ianm8/SW30/README.md

# SW30
A shortwave communications receiver with classic visual design. The SW30 is an SDR that uses quadrature sampling detection.



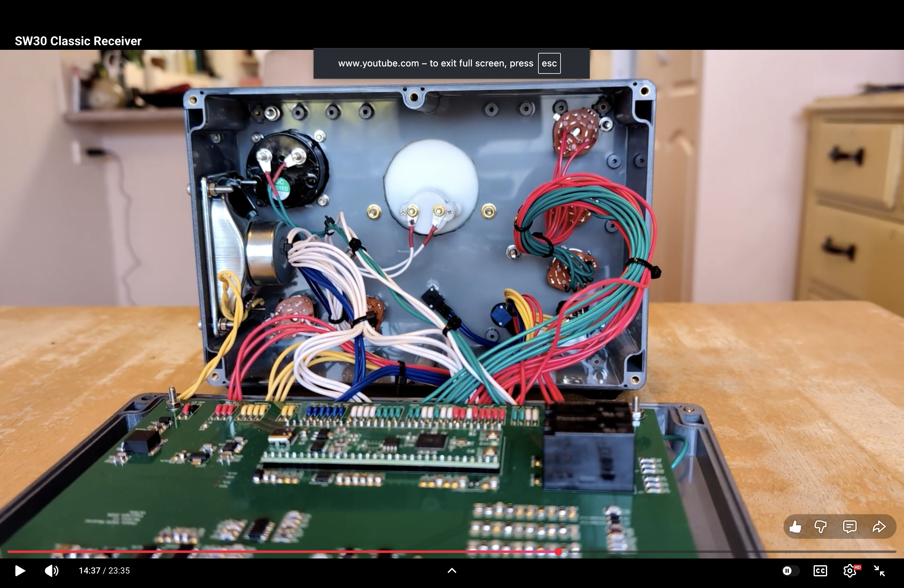
[picture p2: docs/SW30-Video.png]
IMAGE ALT TEXT HERE (https://www.youtube.com/watch?v=dTe6R9eRhOo)


73 VK7IAN
