ianm8/SW30/docs/README.md

## Revision 1.1
 * U14 MC74VHC1GT125DBVT1G
 * U3 BGA616H6327XTSA1
 * Change R49 to 3k
 * Change R55 to 2W

## BOM Notes
* The 5V FSD meter was chosen so that if you don't want to change the dial face then 1 volt represents 1 MHz
* The TCXO can be 25, 26 or 27 MHz (just need to update the source code)
