ianm8/SW30/docs/Schematic_Classic-SW30_2026-02-25.pdf

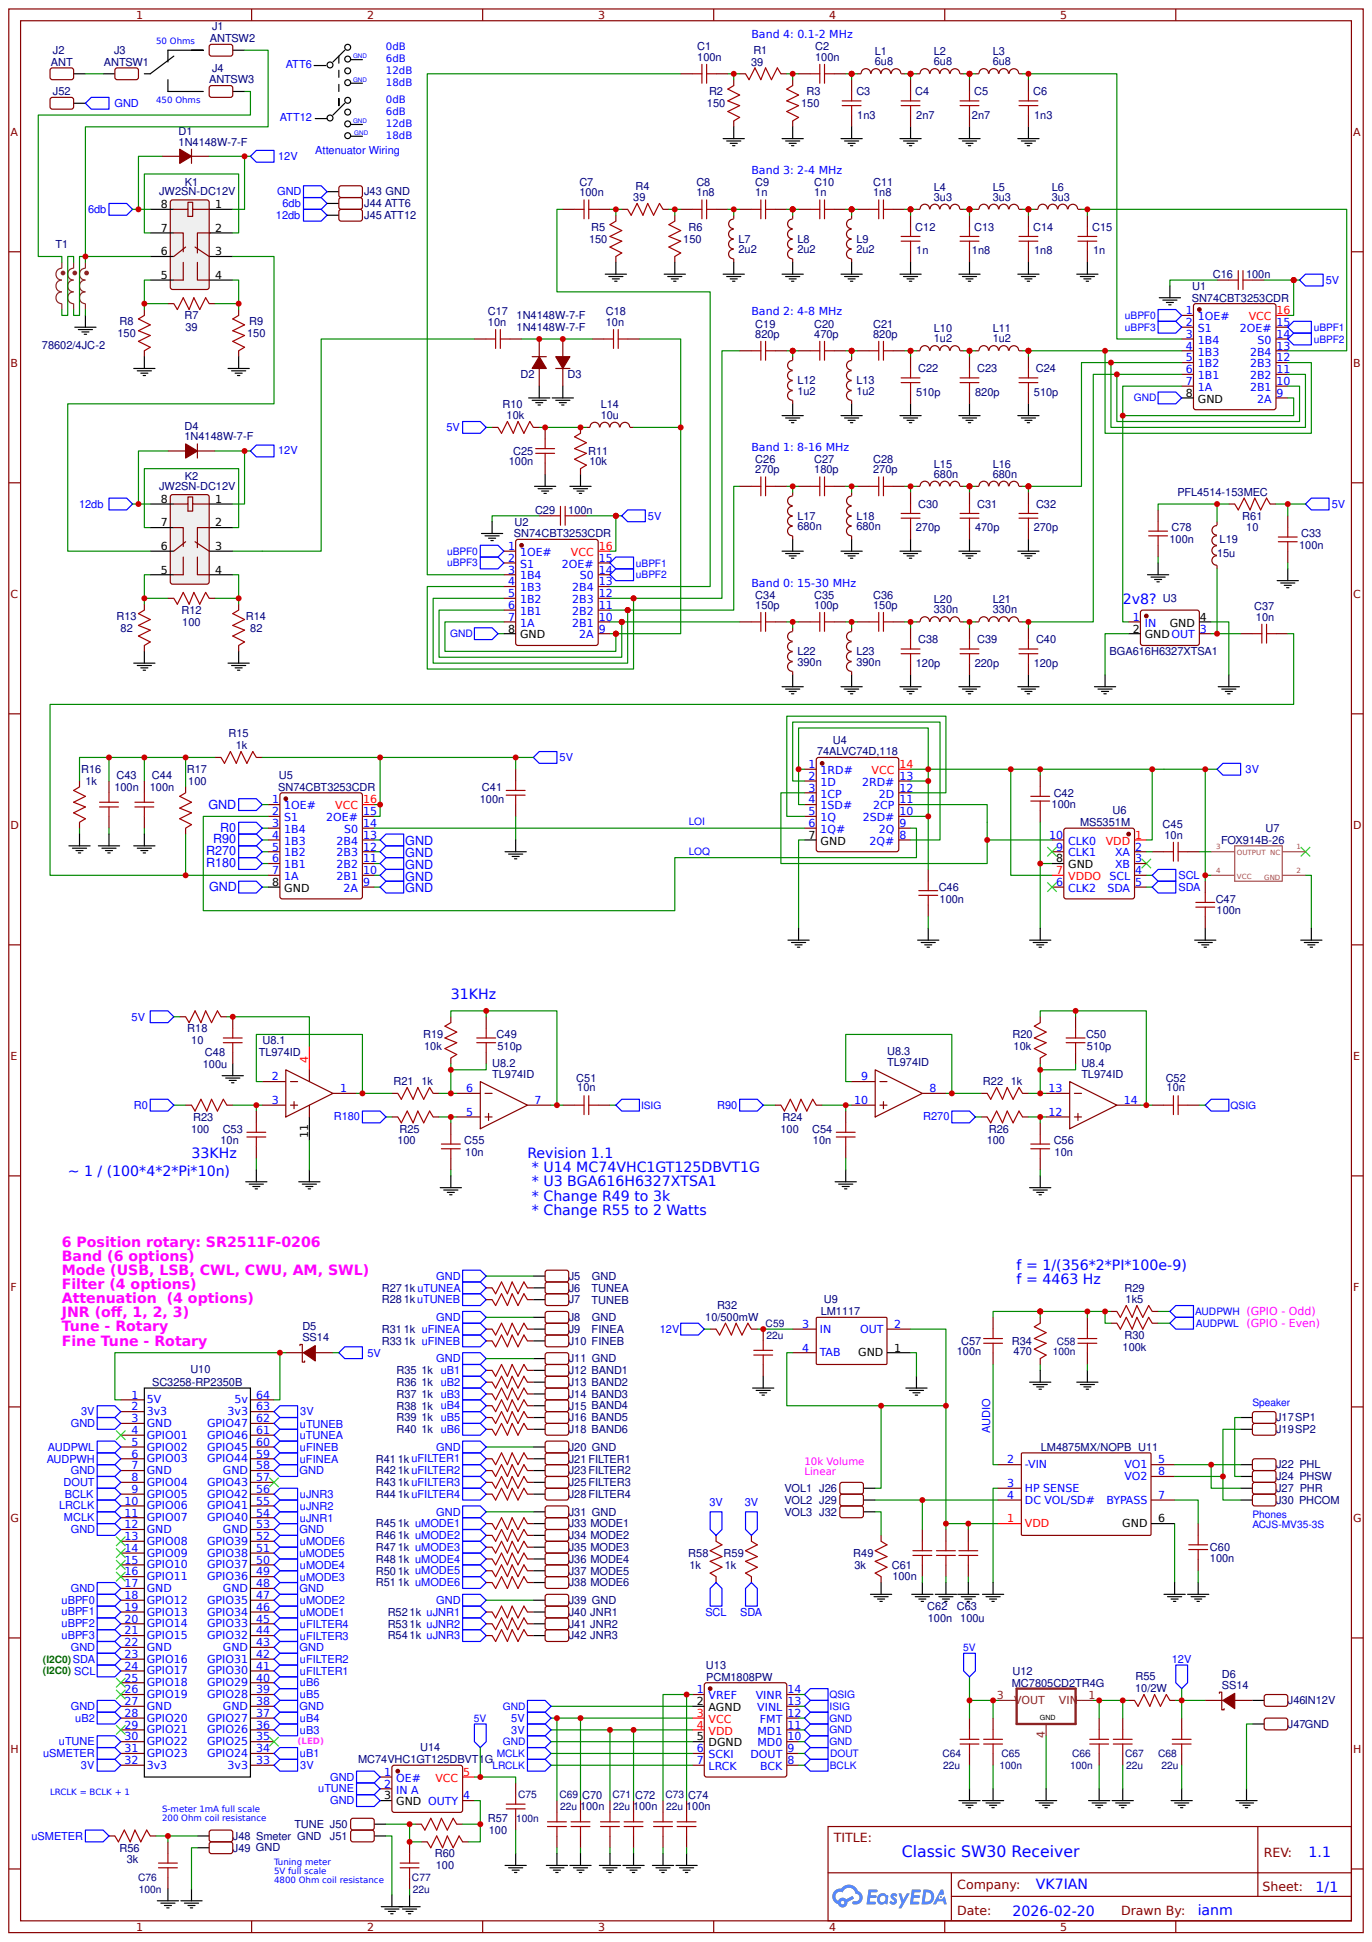
[picture p5: page 1]

6 Position rotary: SR2511F-0206
Band (6 options)
Mode (USB, LSB, CWL, CWU, AM, SWL)
Filter (4 options)
Attenuation (4 options)
JNR (off, 1, 2, 3)
Tune - Rotary
Fine Tune - Rotary

LM4875MX/NOPB U11
BYPASS 7 DC VOL/SD# 4 HP SENSE 3

MC74VHC1GT125DBVT1G
OUTY 4 GND 3 IN A 2 OE# 1
