ianm8/SW30/docs/Meter-4-2.pdf

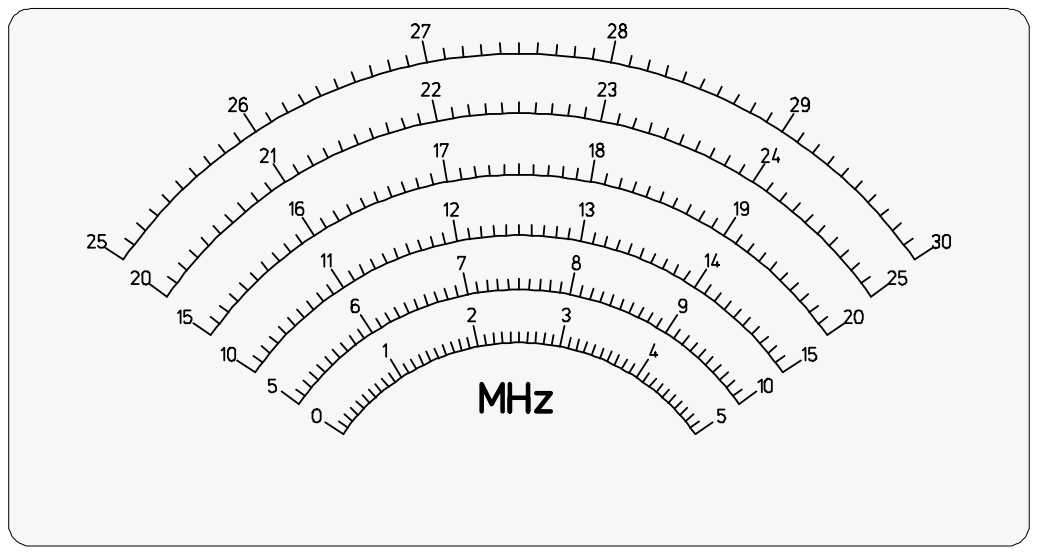
[picture p6: page 1]
