ianm8/SW30/PCB/SW30_Back_Panel.pdf

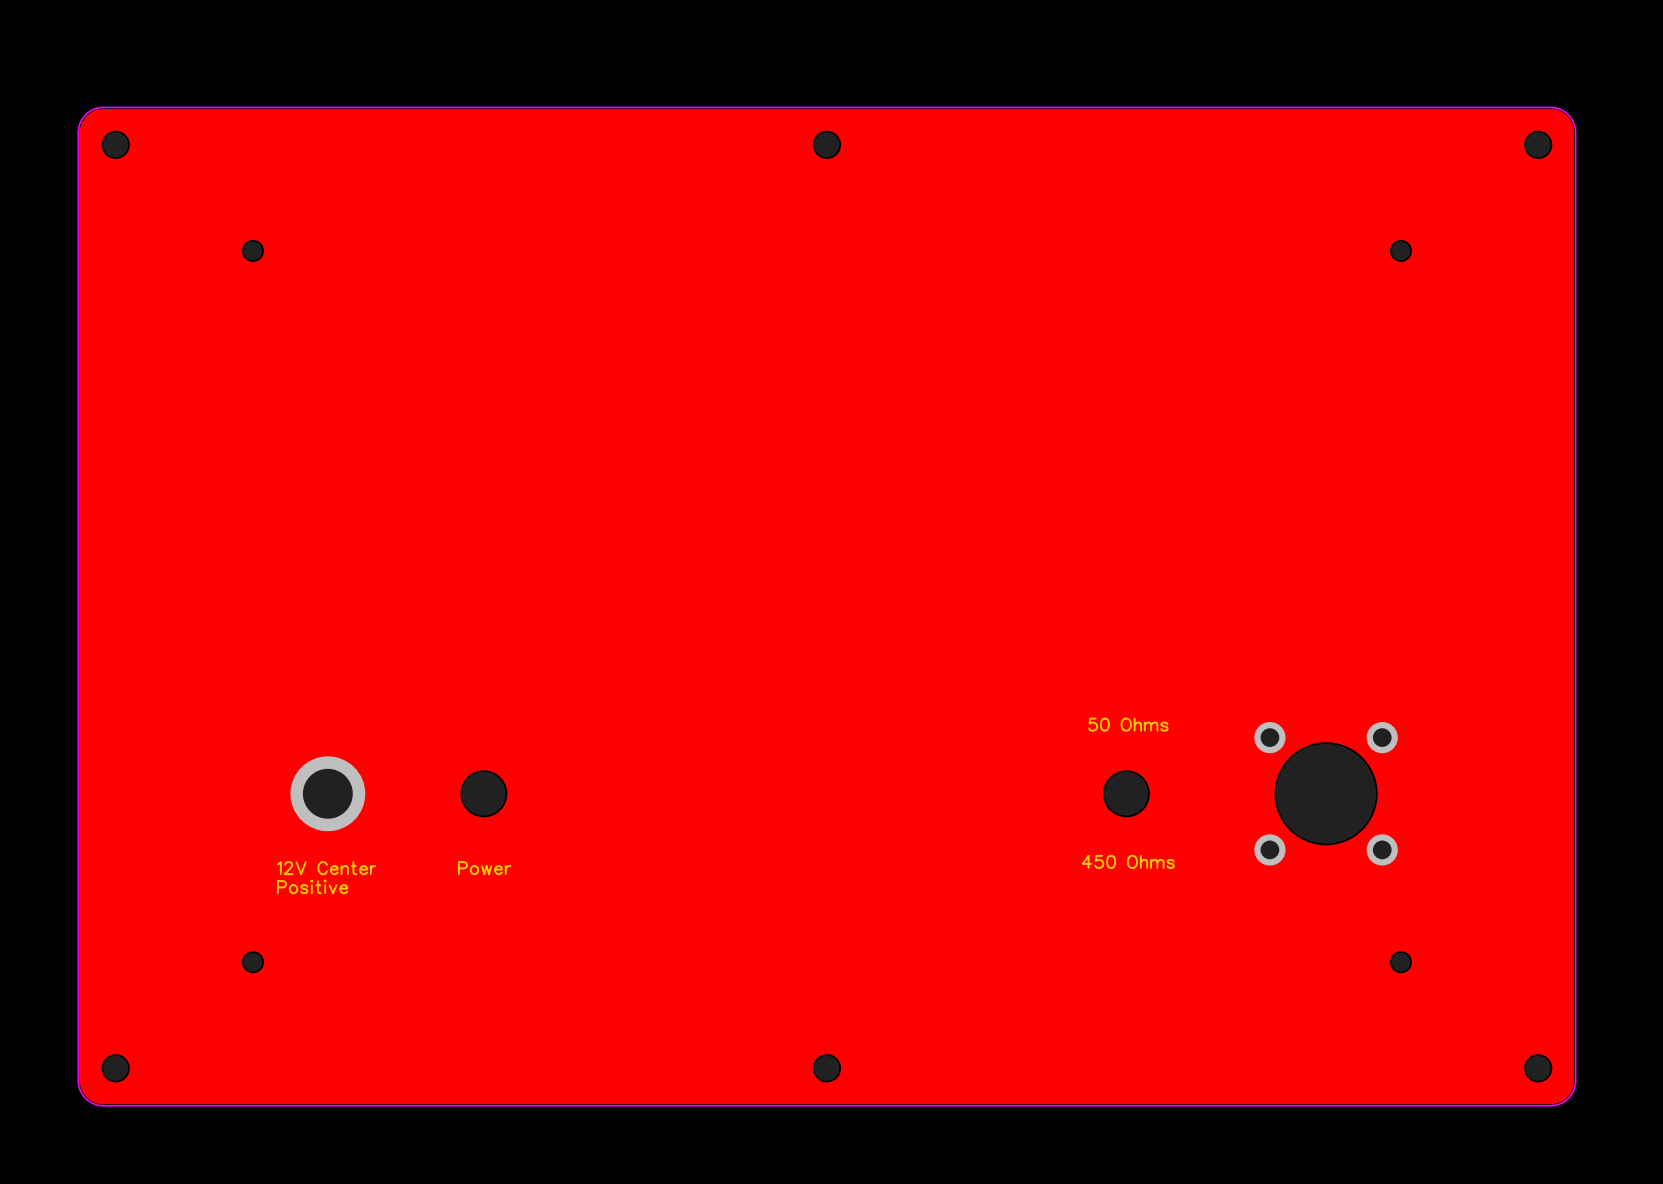
[picture p7: page 1]
