ianm8/SW30/PCB/SW30_Front_Panel.pdf

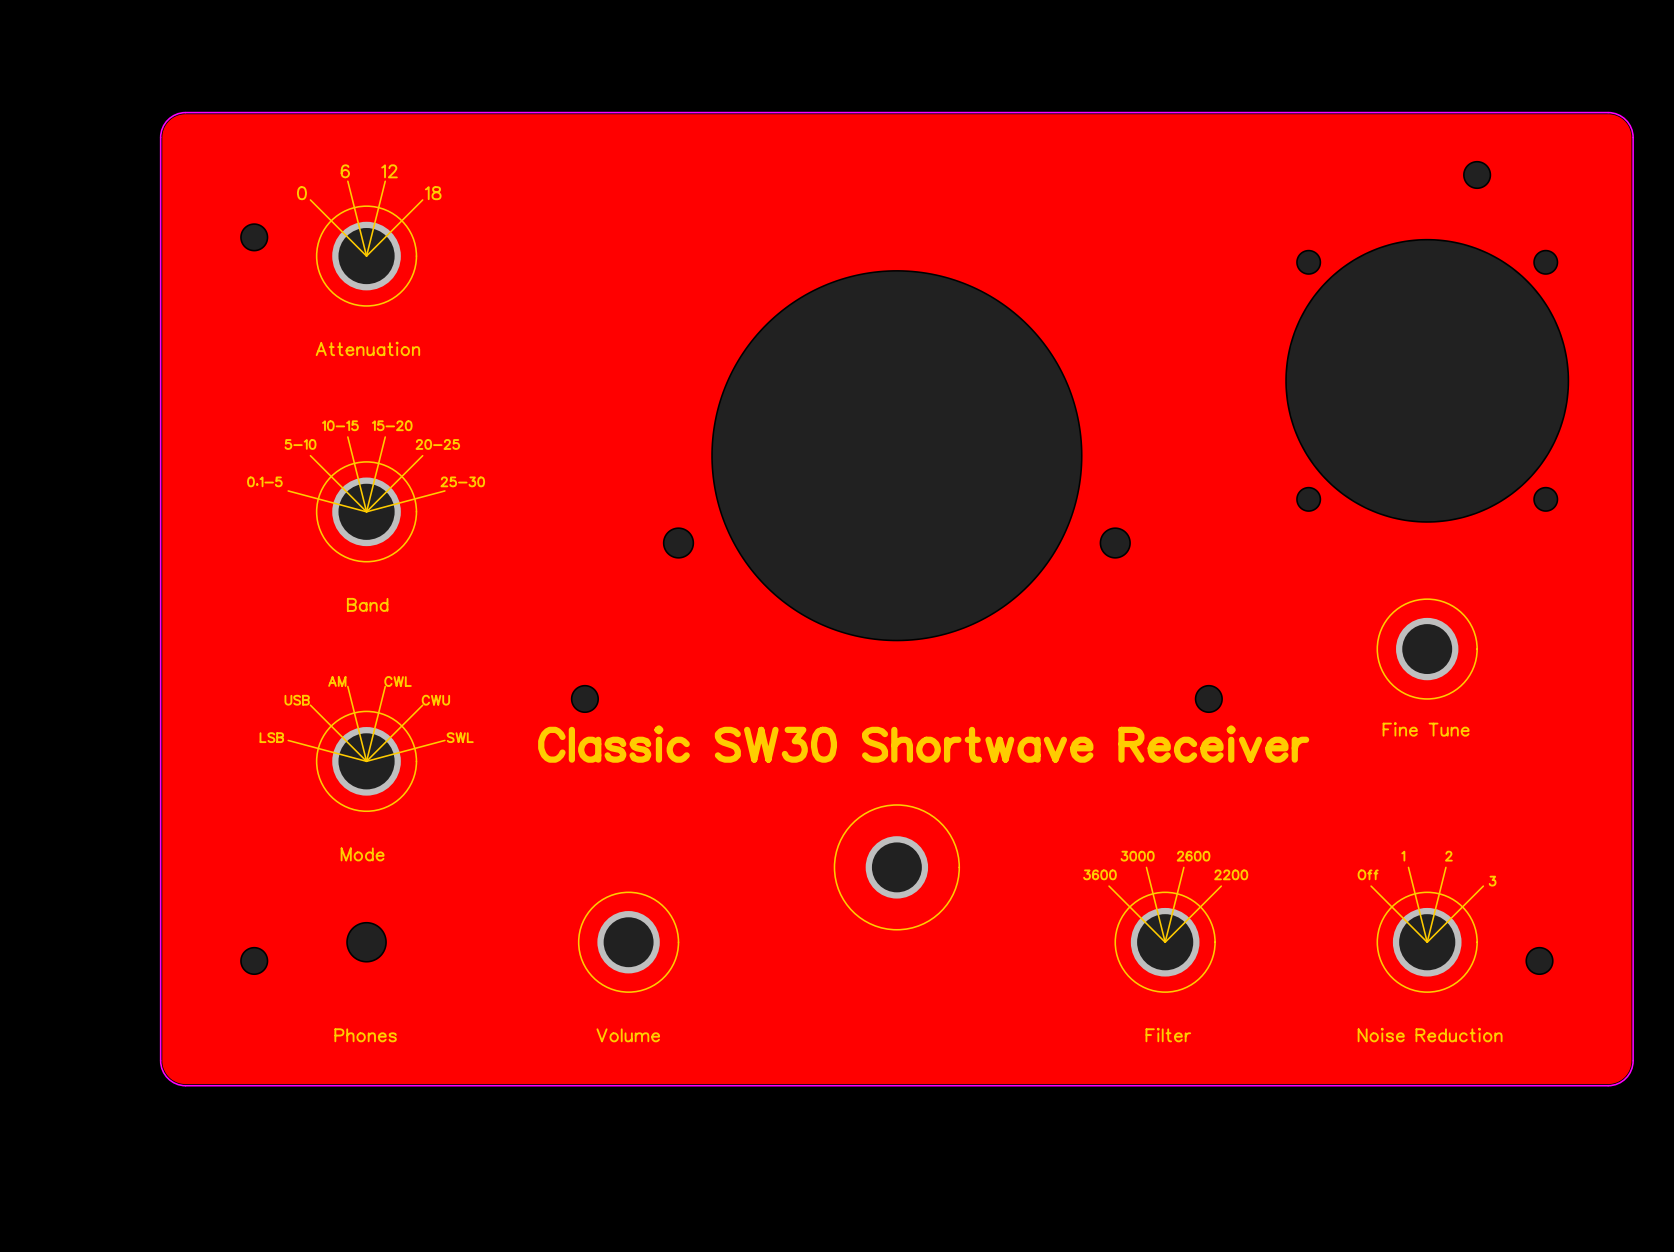
[picture p8: page 1]
