ianm8/SW30/PCB/SW30_PCB_Bottom.pdf

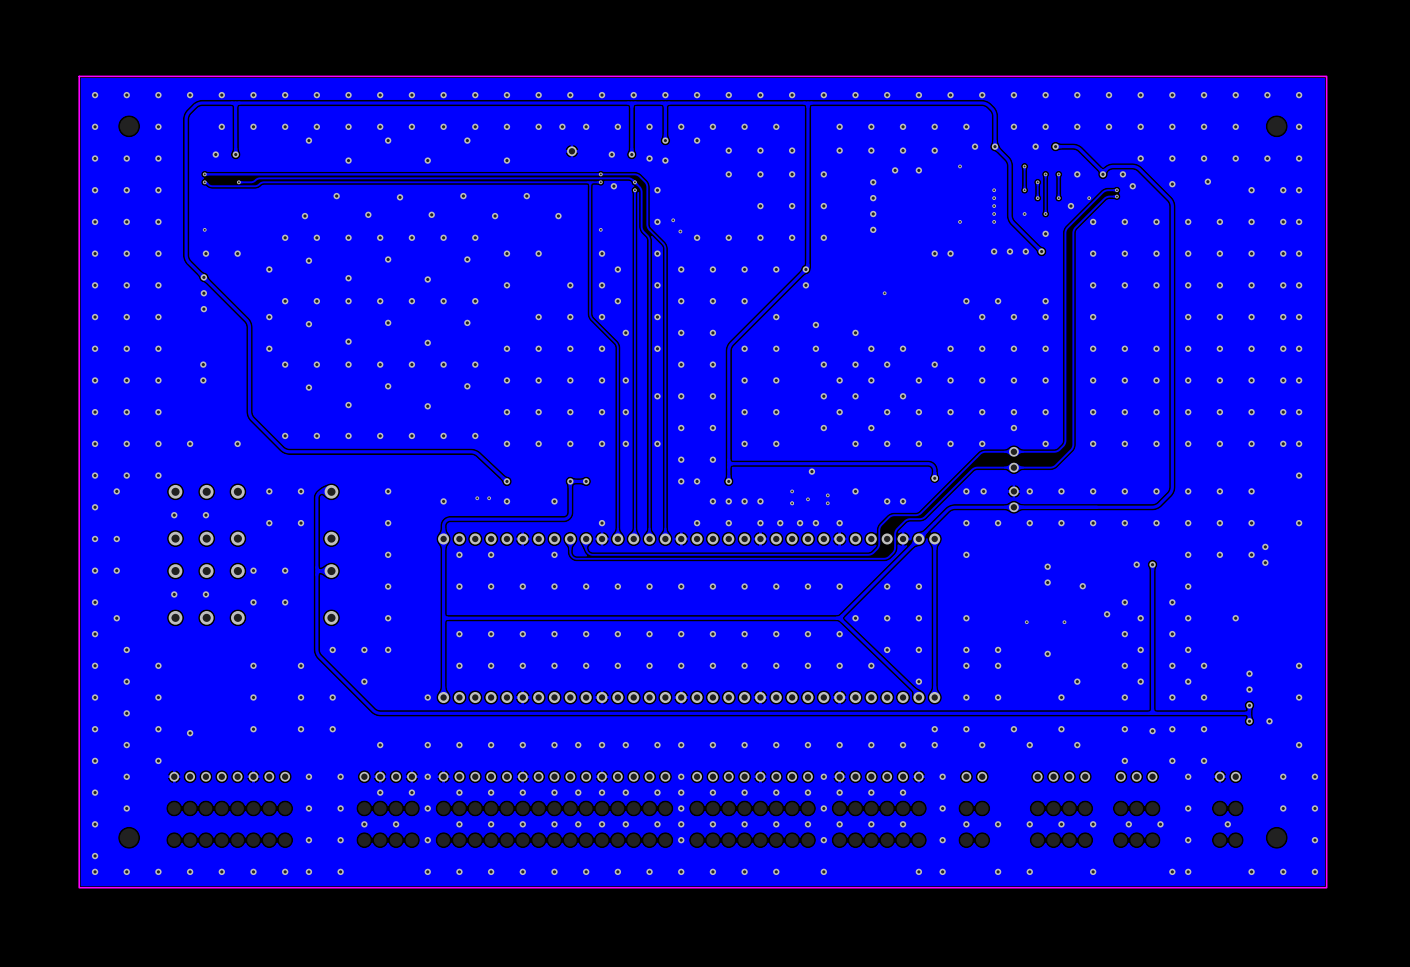
[picture p9: page 1]
