ianm8/SW30/PCB/SW30_PCB_Top.pdf

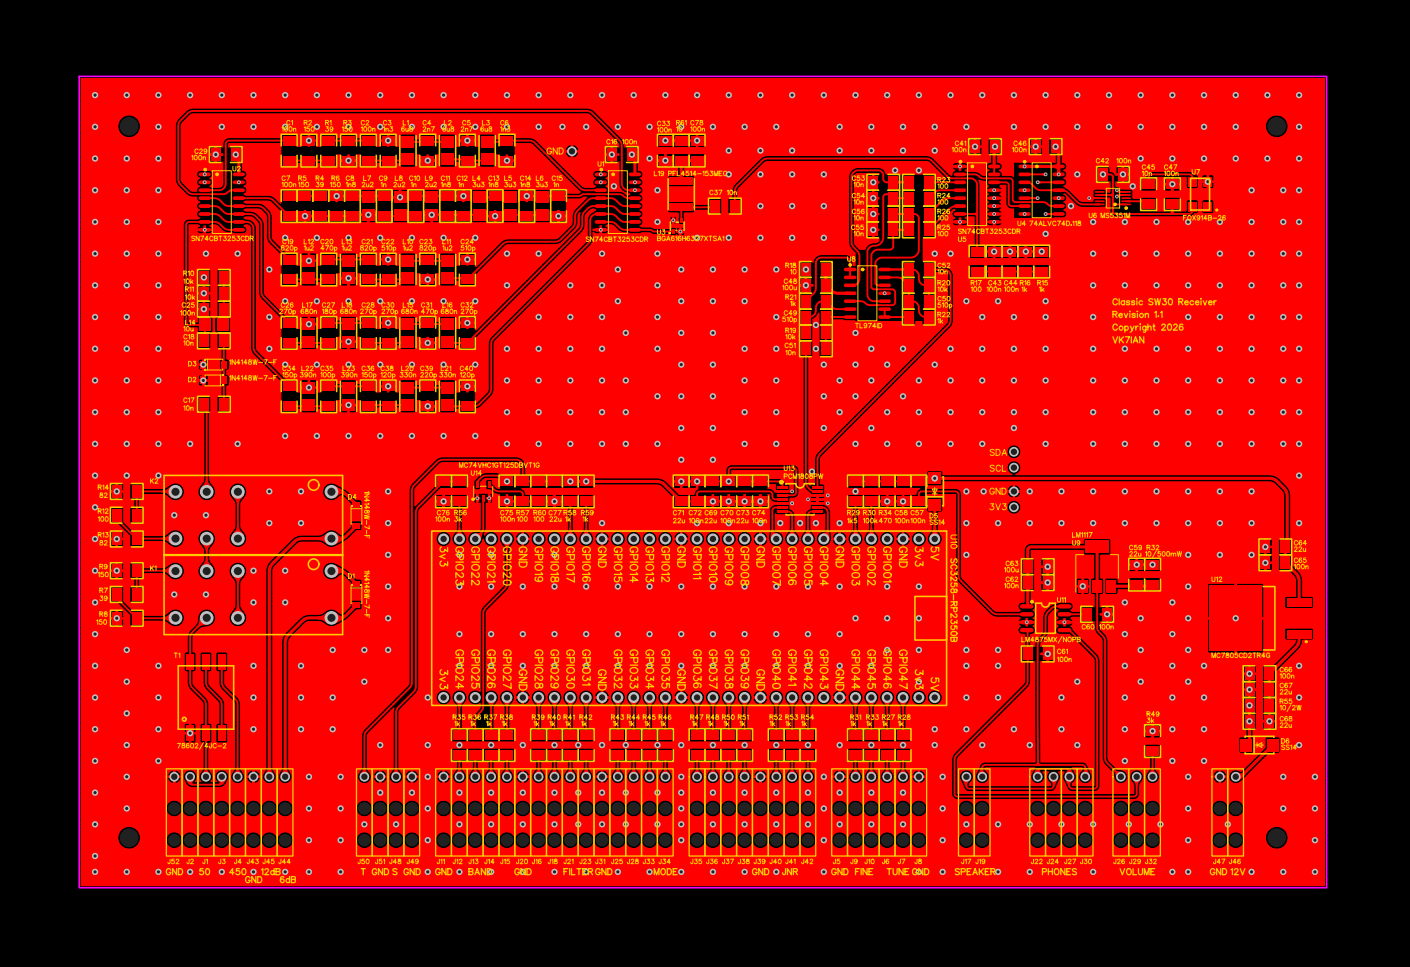
[picture p10: page 1]
