ianm8/SW30/(commit log)

2026-02-21 Update README with Arduino IDE build instructions
    Added build instructions for Arduino IDE 2.
2026-03-02 Add BOM and build notes to README.md
2026-03-04 Update resistor values in README
2026-03-17 Upload BOM
    [BOM_Classic-SW30.csv]
2026-03-17 Fix BOM
    [BOM_Classic-SW30.csv]
2026-03-17 Update README with BOM notes
    Added BOM notes for the 5V FSD meter and TCXO options.
2026-07-07 Version 1.7.240
    Fix s-meter bugs.
    [SW30.ino, dsp.h]
