ianm8/SW30/docs/SW30-PCB-Top.jpg

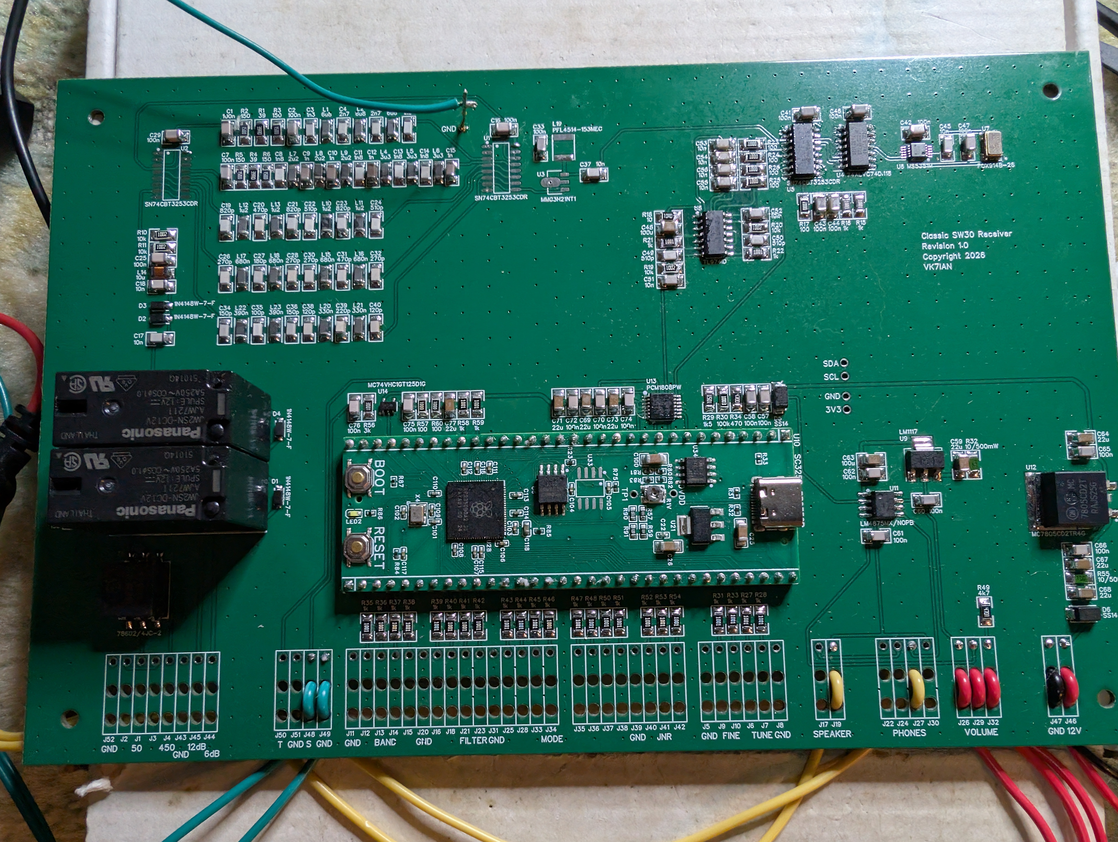
docs/SW30-PCB-Top.jpg
