ianm8/SW30/docs/SW30-Wiring.jpg

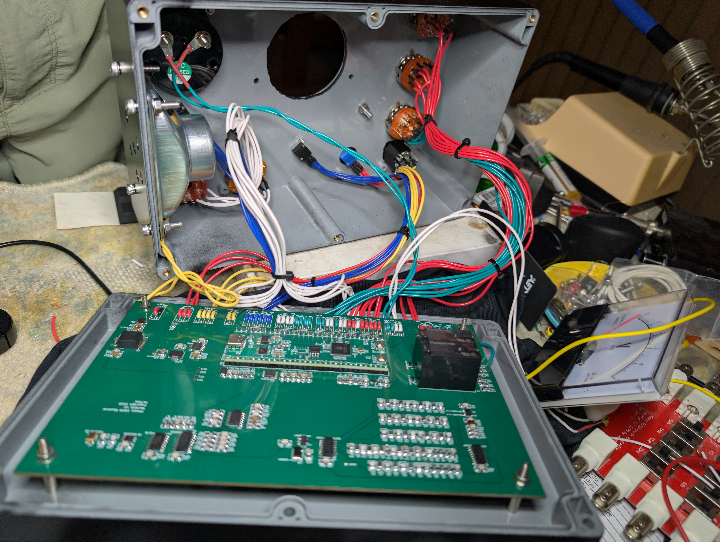
docs/SW30-Wiring.jpg
