ianm8/SW30/docs/SW30-Front.jpg

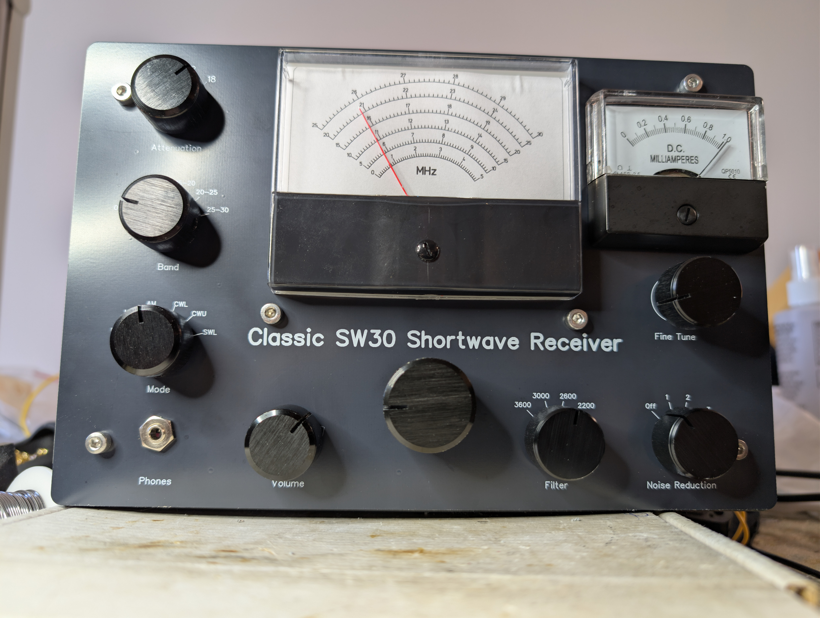
[picture p1: docs/SW30-Front.jpg]
docs/SW30-Front.jpg
